daimapi/vws/(threads)

Thread 1 (2024-08-23):

Weather data is being sent at incorrect times.(must be a RTC error)

daimapi, 2024-08-23:
The RTC timer isn't functioning correctly.
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
Data should be sent at 00:00, 06:00, 12:00, and 18:00 UTC.
While a delay of 30 seconds to 1 minute is acceptable, delays of several hours are far beyond expectations.

daimapi, 2024-08-25:
已修復 fixed in new commit (rtc time zone bug)
[202408252058-rtc bug fix, readme, token.h](https://github.com/daimapi/vws/commit/9842c2b83a7bbfbd0e81fac797e902aa3a515fa2)
任何問題請開新issue
Any problem please open new issue.

daimapi, 2024-08-27:
RTC breaks again
issue close after a entier day of test and commit

daimapi, 2024-08-27:
should set rtc.offset instead of using setTime
fixed and testing :

start
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
close
button
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
close
reset---------------
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
close
wakeup
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
close
wakeup
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
close
button
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
close
wakeup
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
close
wakeup
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
close

daimapi, 2024-08-29:
End test
RTC problem solved in [202408291924-rtc bug fix, readme edit, disconnect protect](https://github.com/daimapi/vws/commit/3747b00538edce7ce492816ef74096d2085eff94)
May still got a few minutes error

Closed 2024-08-29.
