daimapi/vws/(commit log)

2024-08-25 202408252058-rtc bug fix, readme, token.h
    [pms_and_bmp.ino]
2024-08-29 202408291924-rtc bug fix, readme edit, disconnect protect
    [pms_and_bmp.ino]
